Da-Dog/the-summit-project-hardware/TheSummitProject.kicad_pcb

## KiCad design TheSummitProject.kicad_pcb (2026-11-12)

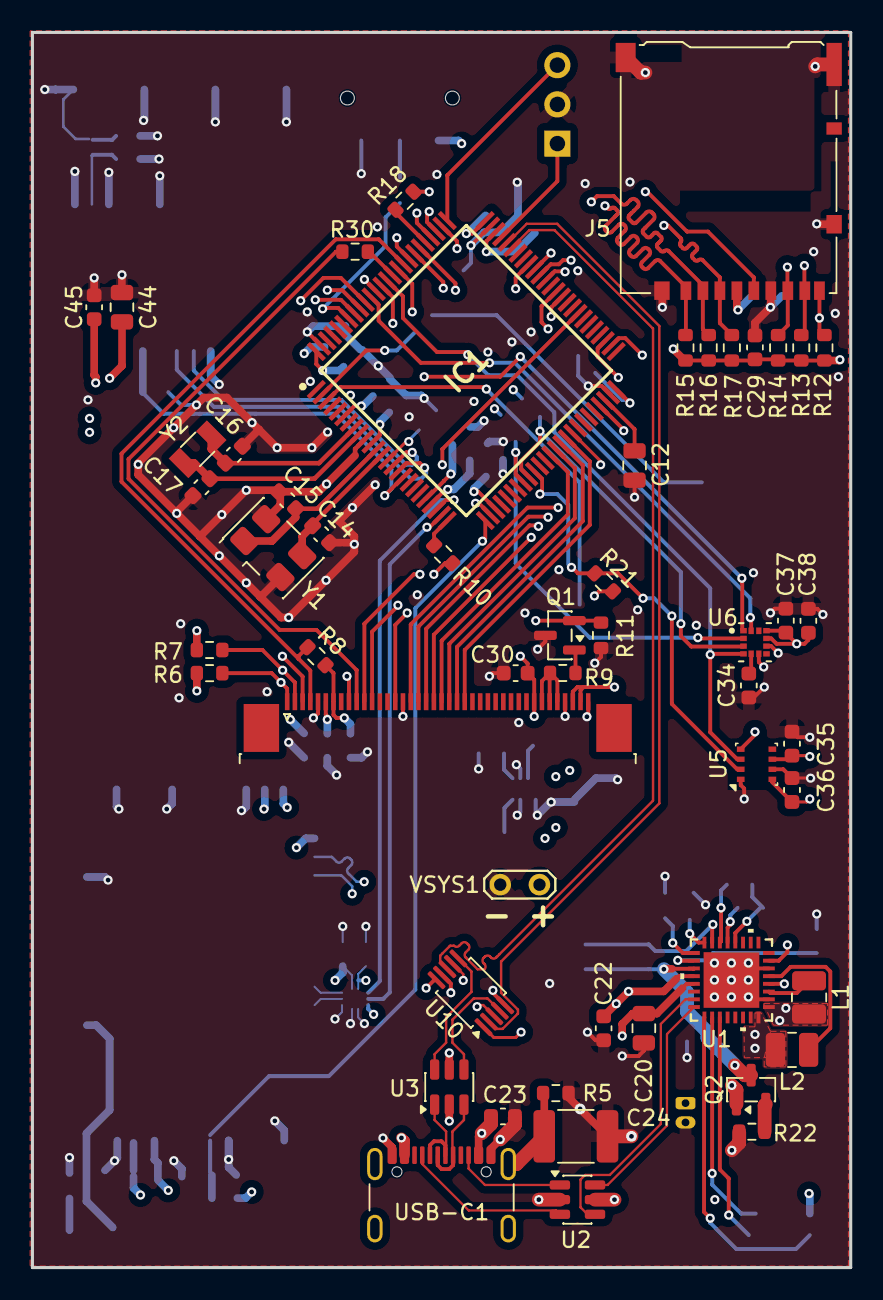
[picture p1: board TheSummitProject.kicad_pcb from above]

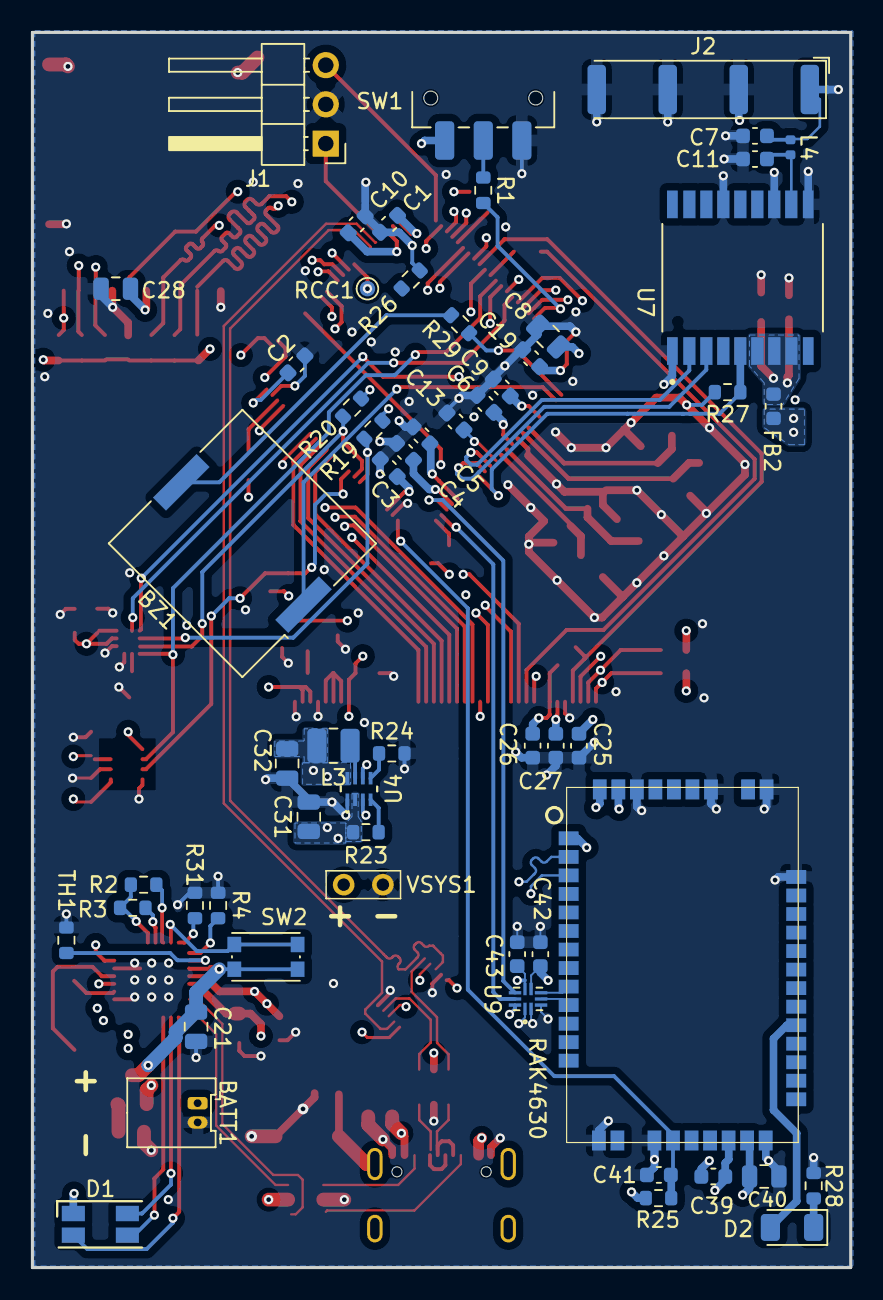
[picture p2: board TheSummitProject.kicad_pcb from below]

Board: 6 copper layers, 53.0 x 80.0 mm, 108 parts (56 on the bottom side), 100 nets.

Parts:
BATT1: Battery Connector; Molex_PicoBlade_53048-0210_1x02_P1.25mm_Horizontal
BZ1: PKLCS1212E4001-R1; Buzzer_Murata_PKLCS1212E
C1, C2, C3, C4, C5, C6, C9, C10, C13, C19, C23, C25, C26, C29, C30, C35, C36, C37, C38, C39, C41, C42, C43, C45: 100n; C_0603_1608Metric
C7: X; C_0603_1608Metric
C8, C28, C32, C40, C44: 10u; C_0805_2012Metric
C11: 1.8p; C_0603_1608Metric
C12, C20, C21, C31: 4.7u; C_0805_2012Metric
C14, C15: 10p; C_0603_1608Metric
C16, C17: 8p; C_0603_1608Metric
C22: 10u; C_0603_1608Metric
C24: 4.7n; C_1812_4532Metric
C27: 1u; C_0603_1608Metric
C34: 220n; C_0603_1608Metric
D1: PWR_LED; LED_RGB_1210
D2: Blue_LED; LED_1206_3216Metric
FB2: 120R; L_0603_1608Metric
IC1: STM32U5F7VJT6; QFP50P1600X1600X160-100N
J1: JTAG; PinHeader_1x03_P2.54mm_Horizontal
J2: GPS_ANT; Antenova_SR4G013_GPS
J4: Screen FPC; TE_4-1734839-0_1x40-1MP_P0.5mm_Horizontal
J5: Micro_SD_Card_Det1; microSD_HC_Hirose_DM3AT-SF-PEJM5
L1, L2, L3: 2.2u; L_1008_2520Metric
L4: 1.8n; L_0402_1005Metric
Q1: NMOS; SOT-23
Q2: PMOS; SOT-23
R1, R11, R13, R14, R15, R16, R17, R25: 10k; R_0603_1608Metric
R2, R3, R6, R7, R8, R19, R20, R21: 4.7k; R_0603_1608Metric
R4: 47k; R_0603_1608Metric
R5: 1m; R_0603_1608Metric
R9: 3.3; R_0603_1608Metric
R10, R28, R29: 100; R_0603_1608Metric
R12, R22, R23, R24, R26, R27: 100k; R_0603_1608Metric
R18: 22; R_0603_1608Metric
R30: 33; R_0603_1608Metric
R31: 300k; R_0603_1608Metric
RCC1: RCC; TestPoint_Pad_D1.0mm
SW1: SW_SPDT; SW_SPDT_CK_JS102011SAQN
SW2: PWR_BTN; SW_Push_1P1T_NO_CK_KMR2
TH1: 10k; R_0603_1608Metric
U1: NPM1300-CAAA-R; QFN32_5X5_NOR
U2, U3: USBLC6-2SC6; SOT-23-6
U4: TPS62840DLCR; VSON8_2P1X1P6_TEX
U5: BME280; Bosch_LGA-8_2.5x2.5mm_P0.65mm_ClockwisePinNumbering
U6: LSM303AGR; PQFN50P200X200X100-12N
U7: MAX-M10S-00B; XCVR_MAX-M10S-00B
U8: RAK4630
U9: SN74AVC2T245RSWR; QFN40P180X140X55-10N
U10: TS3USB30EDGSR; TSSOP-10_3x3mm_P0.5mm
USB-C1: USB C; USB_C_Receptacle_GCT_USB4105-xx-A_16P_TopMnt_Horizontal
VSYS1: VSYS; TestPoint_2Pads_Pitch2.54mm_Drill0.8mm
Y1: 16Mhz; Crystal_SMD_5032-4Pin_5.0x3.2mm
Y2: 32.768Khz; Crystal_SMD_3215-2Pin_3.2x1.5mm

Connections:
+1.8V: C1.1, C2.1, C3.1, C4.1, C5.1, C6.1, C8.1, C9.2, C19.1, C25.1, C26.2, C27.1, C35.2, C36.1, C37.2, C38.1, C43.2, FB2.1, IC1.6 (VBAT), IC1.11 (VDD_1), IC1.21 (VREF+), IC1.22 (VDDA), IC1.28 (VDD_2), IC1.50 (VDD_3), IC1.75 (VDD_4), IC1.100 (VDD_5), J4.6, J4.7, J4.38, J4.39, L1.2, R2.2, R3.2, R6.2, R7.2, R8.2, R19.1, R20.1, R21.1, SW1.3 (C), U1.1 (VOUT1), U1.12 (VDDIO), U5.6 (VDDIO), U5.8 (VDD), U6.9 (VDD), U6.10 (VDD_IO), U9.7 (VCCA), U9.10 (DIR1), U10.10 (VCC)
+3.3V: C10.2, C39.1, C40.1, C42.1, D1.1 (A), IC1.73 (VDDUSB), L2.2, R25.1, U1.32 (VOUT2), U8.40 (VBAT_IO_SX), U8.42 (VBAT_SX), U8.44 (VDD_NRF), U9.6 (VCCB)
+3.3V_HP: C28.2, C29.2, C30.2, C32.1, J4.33, J5.4 (VDD), L3.2, R12.1, R13.1, R14.1, R15.2, R16.2, R17.2, U4.8 (VOS)
/MCU/NRST: C13.1, IC1.14 (NRST)
/MCU/STM32+: IC1.71 (USB_OTG_HS_DP), U10.2 (D1+)
/MCU/STM32-: IC1.70 (USB_OTG_HS_DM), U10.8 (D1-)
/MCU/SW_BOOT0: IC1.94 (PH3-BOOT0), R1.2
/MCU/USB+: U3.3 (I/O2), U3.4 (I/O2), U10.4 (D+), USB-C1.A6 (D+), USB-C1.B6 (D+)
/MCU/USB-: U3.1 (I/O1), U3.6 (I/O1), U10.6 (D-), USB-C1.A7 (D-), USB-C1.B7 (D-)
/MCU/USB_SEL: IC1.42 (PE11), R26.1, U10.1 (S)
ACC_INT: IC1.90 (ACC_INT), U6.12 (INT_1_XL)
BME280_CS: IC1.35 (BME280_CS), R21.2, U5.2 (CSB)
CC1: U1.23 (CC1), U2.4 (I/O2)
CC2: U1.24 (CC2), U2.6 (I/O1)
CTP_INT: IC1.84 (CTP_INT), J4.4, R8.1
CTP_RST: IC1.91 (CTP_RST), J4.3
CTP_SCL: IC1.92 (CTP_SCL), J4.1, R6.1
CTP_SDA: IC1.93 (CTP_SDA), J4.2, R7.1
GND: BATT1.2, C1.2, C2.2, C3.2, C4.2, C5.2, C6.2, C7.2, C8.2, C9.1, C10.1, C11.2, C12.1, C13.2, C14.1, C15.1, C16.1, C17.1, C19.2, C20.1, C21.1, C22.2, C23.2, C24.2, C25.2, C26.1, C27.2, C28.1, C29.1, C30.1, C31.1, C32.2, C34.1, C35.1, C36.2, C37.1, C38.2, C39.2, C40.2, C41.2, C42.2, C43.1, C44.1, C45.2, IC1.10 (VSS_1), IC1.19 (VSSA), IC1.20 (VREF-), IC1.27 (VSS_2), IC1.49 (VSS_3), IC1.74 (VSS_4), IC1.99 (VSS_5), J1.2, J2.2 (Ext), J4.5, J4.16, J4.37, J4.40, J5.6 (VSS), J5.SH (SHIELD), Q1.3 (S), R4.1, R5.1, R11.2, R22.2, R24.2, R26.2, R27.2, R28.2, R31.2, SW1.1 (A), TH1.1, U1.2 (PVSS1), U1.6 (PVSS2), U1.33 (AVSS), U2.2 (GND), U3.2 (GND), U4.1 (GND), U4.3 (MODE), U4.6 (STOP), U5.1 (GND), U5.7 (GND), U6.6 (GND), U6.8 (GND), U7.1 (GND), U7.10 (GND), U7.12 (GND), U7.15 (VIO_SEL), U8.1 (GND), U8.2 (GND1), U8.3 (GND2), U8.4 (GND3), U8.5 (GND4), U8.6 (GND5), U8.7 (GND6), U9.1 (DIR2), U9.2 (~OE), U9.3 (GND), U10.5 (GND), U10.9 (~OE), USB-C1.A1 (GND), USB-C1.A12 (GND), USB-C1.B1 (GND), USB-C1.B12 (GND), VSYS1.2, Y1.2 (G), Y1.4 (G)
GPS_INT: IC1.17 (GPS_INT), R27.1, U7.5 (EXTINT)
GPS_RX: IC1.15 (GPS_RX), U7.2 (TXD)
GPS_TX: IC1.16 (GPS_TX), U7.3 (RXD)
LCD_D0: IC1.61 (LCD_D0), J4.17
LCD_D1: IC1.62 (LCD_D1), J4.18
LCD_D2: IC1.81 (LCD_D2), J4.19
LCD_D3: IC1.82 (LCD_D3), J4.20
LCD_D4: IC1.38 (LCD_D4), J4.21
LCD_D5: IC1.39 (LCD_D5), J4.22
LCD_D6: IC1.40 (LCD_D6), J4.23
LCD_D7: IC1.41 (LCD_D7), J4.24
LCD_NE1: IC1.88 (LCD_NE1), J4.9
LCD_NOE: IC1.85 (LCD_NOE), J4.12
LCD_NWE: IC1.86 (LCD_NWE), R30.2
LCD_PWM: IC1.25 (BPR), R10.1
LCD_RS: IC1.58 (LCD_RS), J4.11
LCD_RST: IC1.77 (LCD_RST), J4.15
LSM303_MAG_CS: IC1.34 (LSM303_MAG_CS), R20.2, U6.3 (CS_MAG)
LSM303_XL_CS: IC1.33 (LSM303_XL_CS), R19.2, U6.2 (CS_XL)
LoRA+: U8.38 (USB+), U10.3 (D2+)
LoRA-: U8.39 (USB-), U10.7 (D2-)
LoRa_RX: IC1.24 (LoRa_RX), U9.9 (A2)
LoRa_TX: IC1.23 (LoRa_TX), U9.8 (A1)
NPM_INT: IC1.52 (NPM_INT), U1.7 (GPIO0)
NRF_RST: C41.1, IC1.26 (NRF_RST), R25.2, U8.8 (NRF_RESET)
unnamed: BATT1.1, Q2.1 (D)
unnamed: BZ1.2 (-), R29.2
unnamed: D1.3 (BK), U1.27 (LED2)
unnamed: D1.4 (GK), U1.26 (LED1)
unnamed: D1.2 (RK), U1.25 (LED0)
unnamed: D2.2 (A), U8.32 (P1.03/LED1)
unnamed: D2.1 (K), R28.1
unnamed: IC1.76 (DEBUG_JTCK-SWCLK), J1.3
unnamed: IC1.72 (DEBUG_JTMS-SWDIO), J1.1
unnamed: C15.2, IC1.12 (HSE_IN), Y1.1
unnamed: C14.2, IC1.13 (HSE_OUT), Y1.3
unnamed: C16.2, IC1.8 (LSE_IN), Y2.1
unnamed: C17.2, IC1.9 (LSE_OUT), Y2.2
unnamed: C12.2, IC1.48 (VCAP)
unnamed: C7.1, J2.1 (In), L4.1
unnamed: J4.10, R30.1
unnamed: J4.34, J4.35, J4.36, R9.1
unnamed: J5.5 (CLK), R18.1
unnamed: Q1.1 (D), R9.2
unnamed: Q1.2 (G), R10.2, R11.1
unnamed: Q2.2 (G), R22.1
unnamed: R1.1, SW1.2 (B)
unnamed: TH1.2, U1.18 (NTC)
unnamed: SW2.1, U1.15 (SHPHLD)
unnamed: L1.1, U1.3 (SW1)
unnamed: L2.1, U1.5 (SW2)
unnamed: R4.2, U1.17 (VSET1)
unnamed: R31.1, U1.16 (VSET2)
unnamed: R23.1, U4.4 (EN)
unnamed: L3.1, U4.7 (SW)
unnamed: R24.1, U4.5 (VSET)
unnamed: C34.2, U6.5 (C1)
unnamed: C11.1, L4.2, U7.11 (RF_IN)
unnamed: C44.2, C45.1, FB2.2, U7.6 (V_BCKP), U7.7 (V_IO), U7.8 (VCC)
unnamed: U8.20 (P0.19/UART1_RX), U9.5 (B1)
unnamed: U8.21 (P0.20/UART1_TX), U9.4 (B2)
unnamed: U2.3 (I/O2), USB-C1.A5 (CC1)
unnamed: U2.1 (I/O1), USB-C1.B5 (CC2)
unnamed: C24.1, R5.2, USB-C1.SH (SHIELD)
PIEZO_P1: BZ1.1 (+), IC1.3 (PIEZO_P2)
PIEZO_P2: IC1.2 (PIEZO_P1), R29.1
PM_SCL: IC1.47 (PM_SCL), R2.1, U1.14 (SCL)
PM_SDA: IC1.53 (PM_SDA), R3.1, U1.13 (SDA)
RCC_MCO: IC1.67 (RCC_MCO), RCC1.1 (Pin_1_1)
SD_CK: IC1.80 (SD_CK), R18.2
SD_CMD: IC1.83 (SD_CMD), J5.3 (CMD), R17.1
SD_D0: IC1.65 (SD_D0), J5.7 (DAT0), R14.2
SD_D1: IC1.66 (SD_D1), J5.8 (DAT1), R13.2
SD_D2: IC1.78 (SD_D2), J5.1 (DAT2), R15.1
SD_D3: IC1.79 (SD_D3), J5.2 (DAT3/CD), R16.1
SD_DETECT: IC1.64 (SD_DETECT), J5.9 (DET), R12.2
SNSR_MOSI: IC1.87 (SNSR_MOSI), U5.3 (SDI), U6.4 (SDA/SDI/SDO)
SNSR_SCK: IC1.89 (SNSR_SCK), U5.4 (SCK), U6.1 (SCL/SPC)
VBAT: C21.2, Q2.3 (S), SW2.2, U1.19 (VBAT)
VBUS: C20.2, C23.1, U1.21 (VBUS), U2.5 (VBUS), U3.5 (VBUS), U8.43 (VBUS), USB-C1.A4 (VBUS), USB-C1.A9 (VBUS), USB-C1.B4 (VBUS), USB-C1.B9 (VBUS)
VSYS: C22.1, C31.2, R23.2, U1.4 (PVDD), U1.20 (VSYS), U4.2 (VIN), U8.41 (VBAT_NRF), VSYS1.1
