Da-Dog/the-summit-project-hardware/(commit log)

2026-08-10 Basic Power Schematic
    [TheSummitProject.kicad_pcb, TheSummitProject.kicad_sch]
2026-08-10 Added clocks
    [TheSummitProject.kicad_sch]
2026-08-10 Added extra decouplings for analog, connected VREF
    [TheSummitProject.kicad_sch]
2026-08-10 added markings labels
    [TheSummitProject.kicad_sch]
2026-08-10 added PMIC schematic
    [TheSummitProject.kicad_sch, pmic.kicad_sch]
2026-08-11 fixed ERC warnings, finalized PMIC
    [TheSummitProject.kicad_sch, pmic.kicad_sch]
2026-08-11 added symbol library
    [TheSummitProject.kicad_sch, pmic.kicad_sch]
2026-08-11 added ESD protection for USB
    [TheSummitProject.kicad_sch]
2026-08-11 added screen schematic
    [TheSummitProject.kicad_sch, pmic.kicad_sch, screen.kicad_sch]
2026-08-11 added LCD_RST to MCU page
    [TheSummitProject.kicad_sch]
2026-08-11 added sd schematic
    [TheSummitProject.kicad_sch, sd.kicad_sch]
2026-08-11 added peripherals pins
    [TheSummitProject.kicad_sch, peripherals.kicad_sch, pmic.kicad_sch]
2026-08-11 added pcb file
    [TheSummitProject.kicad_pcb]
2026-08-12 added resistance to CS pins
    [TheSummitProject.kicad_sch]
2026-08-12 assigned footprint and created PCB file
    [TheSummitProject.kicad_pcb, TheSummitProject.kicad_sch, peripherals.kicad_sch, pmic.kicad_sch, screen.kicad_sch, sd.kicad_sch]
2026-08-13 migrated display power with lora
    [TheSummitProject.kicad_pcb, peripherals.kicad_sch, pmic.kicad_sch, screen.kicad_sch]
2026-08-13 modify PCB layout
    [TheSummitProject.kicad_pcb]
2026-08-13 modify lora
    [TheSummitProject.kicad_pcb]
2026-08-14 wire usbc and cystal
    [TheSummitProject.kicad_pcb]
2026-08-14 pcb wiring
    [TheSummitProject.kicad_pcb]
2026-08-15 changed NPM1300 BGA to QFN package
    [pmic.kicad_sch]
2026-08-15 changed NPM1300 BGA to QFN footprint
    [TheSummitProject.kicad_pcb]
2026-08-15 changed screen footprint
    [TheSummitProject.kicad_pcb, pmic.kicad_sch, screen.kicad_sch]
2026-08-16 Updated footprints fixed DRC errors
    [TheSummitProject.kicad_sch, screen.kicad_sch]
2026-08-16 Updated footprints for RCC_MCO to test point
    [peripherals.kicad_sch]
2026-08-16 Changed pcb to 4 layers and completed 50% traces
    [TheSummitProject.kicad_pcb, TheSummitProject.kicad_sch, peripherals.kicad_sch, pmic.kicad_sch]
2026-08-16 Changed usbc footprint
    [TheSummitProject.kicad_sch]
2026-08-17 added 90% pcb traces
    [TheSummitProject.kicad_pcb]
2026-08-22 Redesigned PCB layout 90% done
    [TheSummitProject.kicad_pcb]
2026-08-23 Layout PCB
    [TheSummitProject.kicad_pcb]
2026-08-23 DFM tested and edited
    [TheSummitProject.kicad_pcb]
2026-08-25 Added data for pcb fab
    [TheSummitProject.kicad_sch, peripherals.kicad_sch, pmic.kicad_sch, screen.kicad_sch, sd.kicad_sch]
2026-09-02 Updated footprint of 32.768k crystal to 3215
    [TheSummitProject.kicad_pcb, TheSummitProject.kicad_sch]
2026-09-18 Added reverse polarity protection circuit, PCB not implemented
    [pmic.kicad_sch]
2026-10-01 Updated with new power rails, added sensors and gps symbol
    [TheSummitProject.kicad_sch, peripherals.kicad_sch, pmic.kicad_sch, screen.kicad_sch, sd.kicad_sch]
2026-10-03 UPDATE U567
    [peripherals.kicad_sch]
2026-10-06 UPDATE RAK4630
    [peripherals.kicad_sch]
2026-10-06 Modified lora module design, still need led and usb connected for flashing
    [peripherals.kicad_sch]
2026-10-08 Added logic level shifter for lora
    [TheSummitProject.kicad_sch, peripherals.kicad_sch]
2026-10-21 added mux for usb, cleaned up schematic for pcb design, setup new pcb with correct size
2026-10-22 changed FB2 to 120R to consilidate BOM
2026-10-23 Changed SPI to 3-wire, added Accelerometer interupt
2026-10-23 pcb v2 layer change placed chip
2026-10-24 pcb draft, cleaned up schematic
2026-10-24 PCB DRAFT
2026-10-25 pcb draft screen and SD card
2026-10-27 changed JTAG pins, rerouted some wires
2026-10-31 restarted everything with a 6 layer board, added most core components onto the board, next step hook up data for RAK and design power circuit
2026-11-01 cleaned up silkscreen
2026-11-06 optimized power layer
2026-11-06 optimized battery charging traces
2026-11-08 changed battery pin type
